YetAnotherElectronicsChannel/Self-Oscillating-ClassD/spice_schematic.pdf

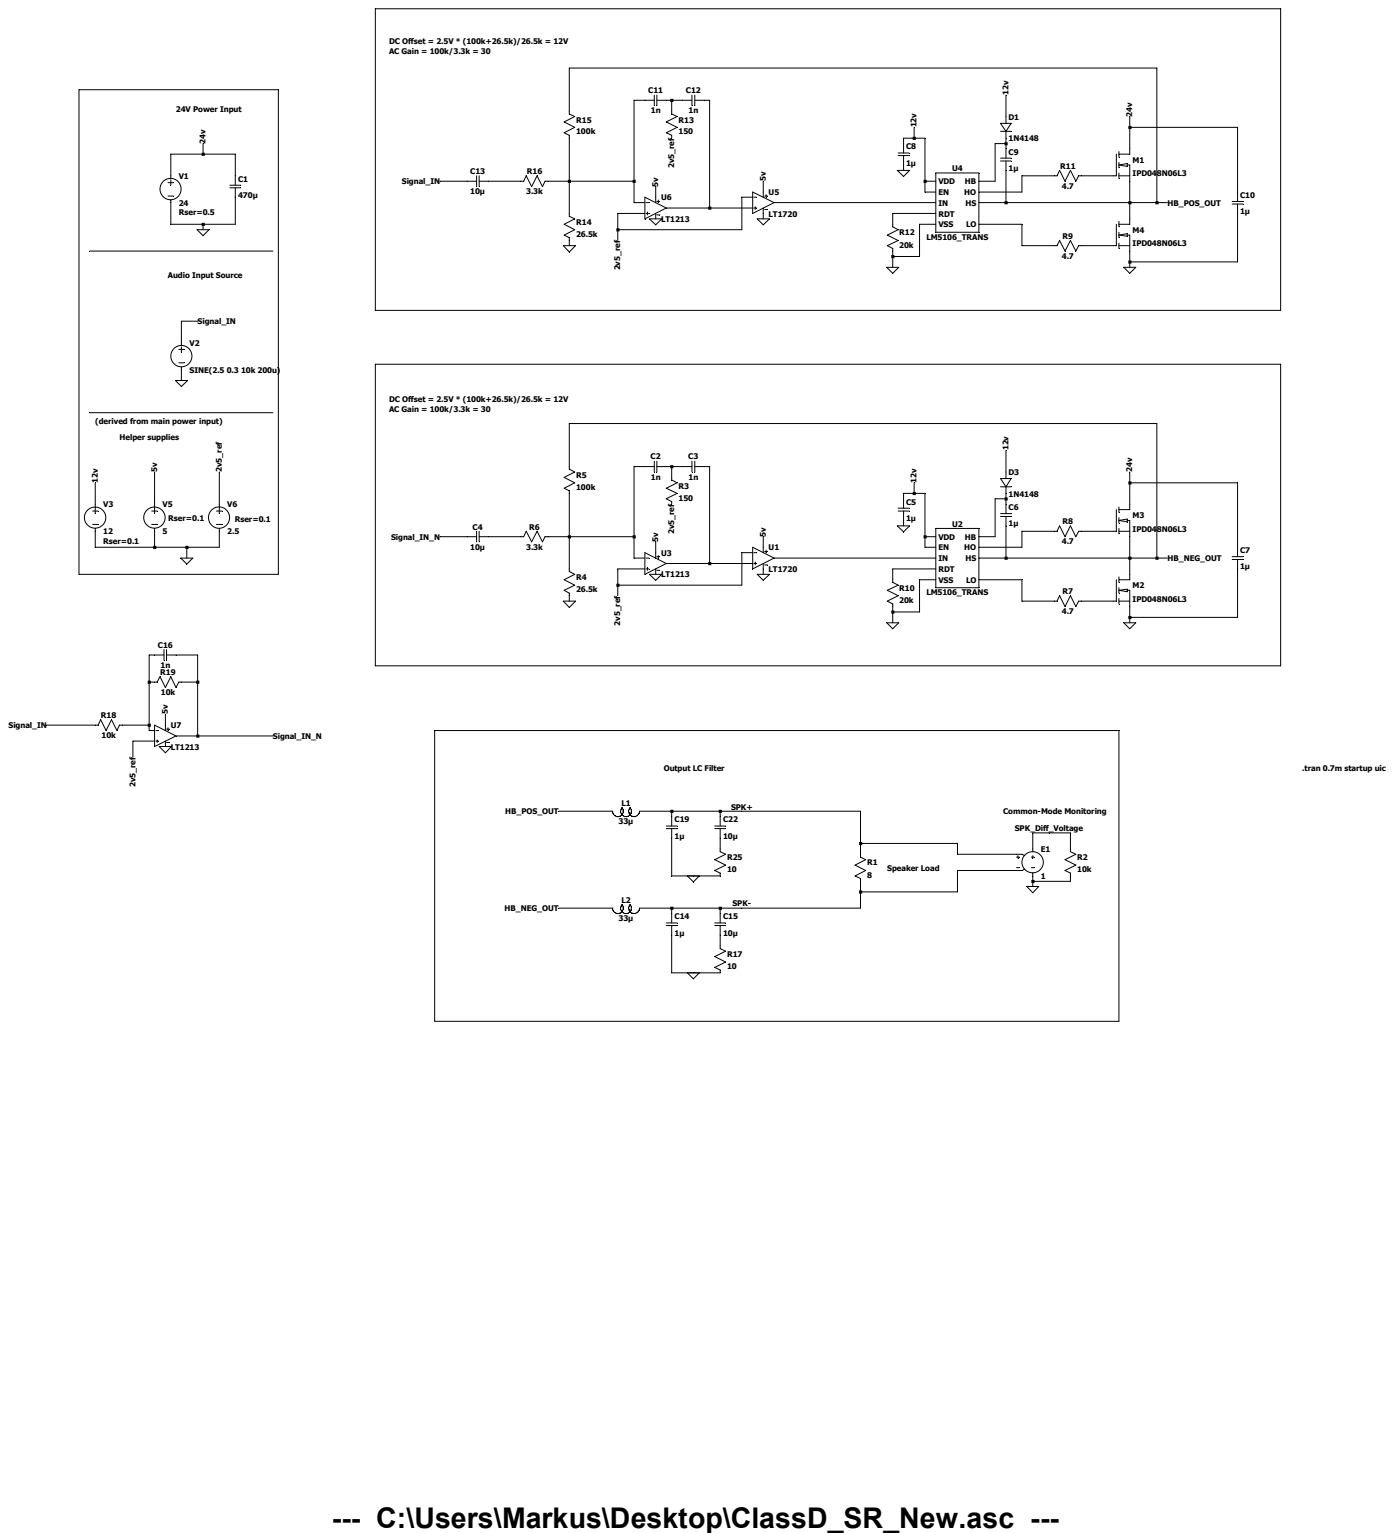
[picture p6: page 1]

(derived from main power input)
Helper supplies

--- C:\Users\Markus\Desktop\ClassD_SR_New.asc ---
