YetAnotherElectronicsChannel/Self-Oscillating-ClassD/ClassD_SR_New.asc

C1: cap; 470µ; V=IC=24
C2: cap; 1n
C3: cap; 1n
C4: cap; 10µ
C5: cap; 1µ
C6: cap; 1µ
C7: cap; 1µ
C8: cap; 1µ
C9: cap; 1µ
C10: cap; 1µ
C11: cap; 1n
C12: cap; 1n
C13: cap; 10µ
C14: cap; 1µ
C15: cap; 10µ
C16: cap; 1n
C19: cap; 1µ
C22: cap; 10µ
D1: diode; 1N4148
D3: diode; 1N4148
E1: e; 1
L1: ind; 33µ
L2: ind; 33µ
M1: nmos; IPD048N06L3
M2: nmos; IPD048N06L3
M3: nmos; IPD048N06L3
M4: nmos; IPD048N06L3
R1: res; 8
R2: res; 10k
R3: res; 150
R4: res; 26.5k
R5: res; 100k
R6: res; 3.3k
R7: res; 4.7
R8: res; 4.7
R9: res; 4.7
R10: res; 20k
R11: res; 4.7
R12: res; 20k
R13: res; 150
R14: res; 26.5k
R15: res; 100k
R16: res; 3.3k
R17: res; 10
R18: res; 10k
R19: res; 10k
R25: res; 10
U1: LT1720
U2: LM5106_TRANS
U3: LT1213
U4: LM5106_TRANS
U5: LT1720
U6: LT1213
U7: LT1213
V1: voltage; 24; Rser=0.5
V2: voltage; SINE(2.5 0.3 10k 200u)
V3: voltage; 12; Rser=0.1
V5: voltage; 5; Rser=0.1
V6: voltage; 2.5; Rser=0.1
Named nets: 0, 24v, Signal_IN, 12v, 5v, 2v5_ref, HB_NEG_OUT, SPK+, HB_POS_OUT, SPK_Diff_Voltage, Signal_IN_N, SPK-
24V Power Input
Audio Input Source
Speaker Load
.tran 0.7m startup uic
Helper supplies
(derived from main power input)
Output LC Filter
Common-Mode Monitoring
DC Offset = 2.5V * (100k+26.5k)/26.5k = 12V
AC Gain = 100k/3.3k = 30
DC Offset = 2.5V * (100k+26.5k)/26.5k = 12V
AC Gain = 100k/3.3k = 30
