YetAnotherElectronicsChannel/Self-Oscillating-ClassD/(threads)

Thread 1 (2021-02-04):

Missing code for component LM5106_TRANS

ldrozd1977, 2021-02-04:
The code repository is missing the custom component "LM5106_TRANS" (for the power stage).

YetAnotherElectronicsChannel, 2021-02-04:
The spice model can be downloaded directly from TI:
https://www.ti.com/lit/zip/snvmac8

I didn't want to share it over GitHub in order not to run into legal problems

ldrozd1977, 2021-02-05:
Thanks!

Closed 2021-02-04.
